antoine-voiry/saucedeck/docs/kb/README.md

# Knowledge cache

Verified facts so nobody re-researches. One topic per file. Format per entry:

- **Fact.** `[verified: <source>, YYYY-MM-DD]` or `[unverified]`

Files:
- [esp32s3.md](esp32s3.md) — ESP32-S3 SoC + SuperMini board
- [toolchain.md](toolchain.md) — pioarduino, PlatformIO, Arduino-ESP32 USB/HID
- [peripherals.md](peripherals.md) — MCP23017 (current), PCF8575 (legacy), EC11, ST7789, WS2812B
