antoine-voiry/saucedeck/docs/superpowers/specs/assets/2026-10-31-candy-mockup.png

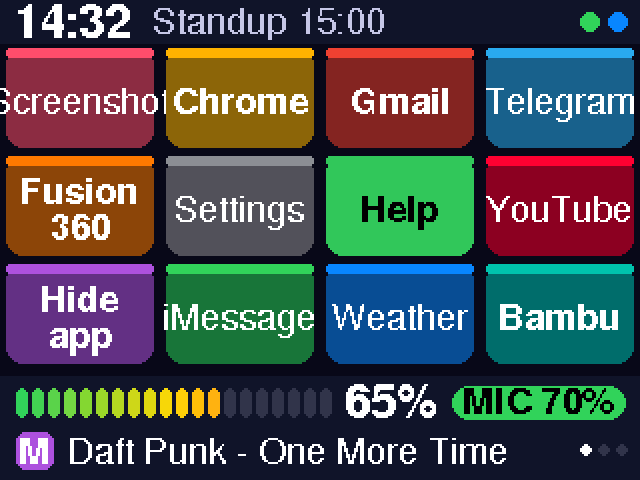
docs/superpowers/specs/assets/2026-10-31-candy-mockup.png
