antoine-voiry/saucedeck/docs/superpowers/specs/assets/2026-10-31-candy-sim.png

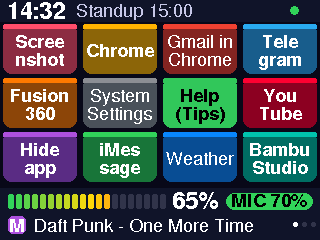
docs/superpowers/specs/assets/2026-10-31-candy-sim.png
