antoine-voiry/saucedeck/hardware/stl/SauceDeck-V1.1-base-pockets.step

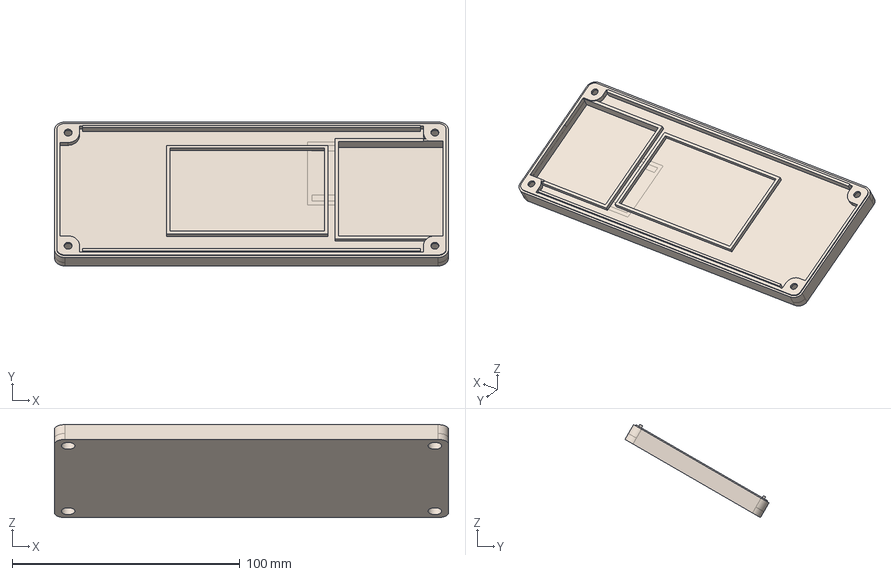
[picture p4: CAD file, 2026-11-08]
hardware/stl/SauceDeck-V1.1-base-pockets.step
173.1 x 63.3 x 41.0 mm
