antoine-voiry/saucedeck/hardware/stl/SauceDeck-V1.1-lcd-bezel.stl

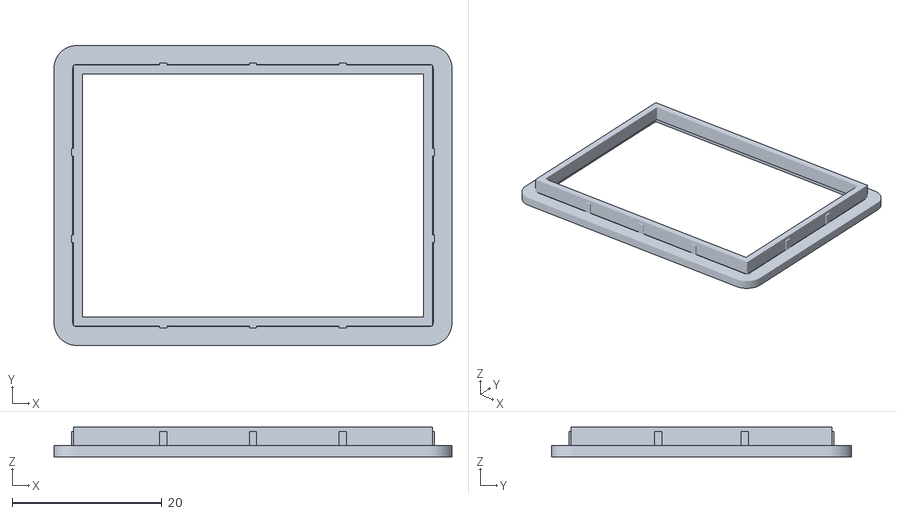
[picture p5: CAD file, 2026-11-08]
hardware/stl/SauceDeck-V1.1-lcd-bezel.stl
53.1 x 40.0 x 4.00
