antoine-voiry/saucedeck/hardware/stl/SauceDeck-V1.1-key-bezel.stl

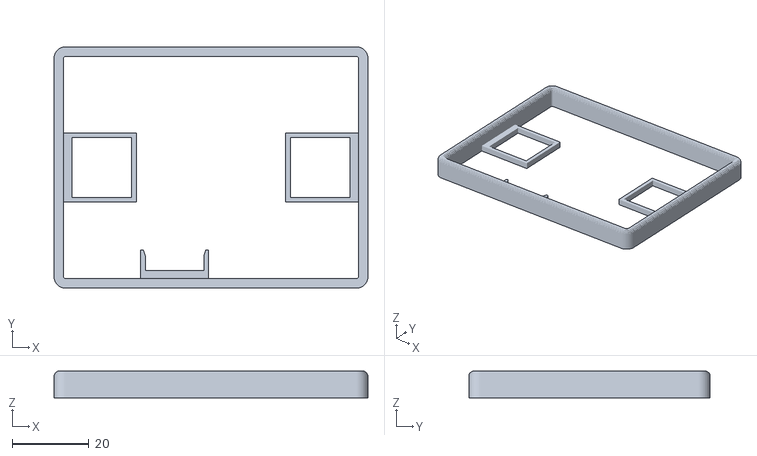
[picture p6: CAD file, 2026-11-08]
hardware/stl/SauceDeck-V1.1-key-bezel.stl
82.0 x 63.0 x 7.00
