antoine-voiry/saucedeck/(list of files, cad)

Other CAD files:
hardware/stl/SauceDeck-V1.1-base-pockets.stl
