antoine-voiry/saucedeck/docs/bringup/README.md

# Bring-up logs

One file per bench session: `YYYY-MM-DD.log`, serial output of the bringup firmware (`pio device monitor`, or `tools/bench.py` replies for host-driven sessions — trimmed to the relevant lines).
Note any rework done between runs at the top of the file.
