antoine-voiry/saucedeck/(commit log)

2026-10-04 Initial SAUCEDECK firmware scaffold
    ESP32-S3-Zero USB HID macro deck on pioarduino (Arduino core 3.x).
    - Enumerates as SAUCEDECK via TinyUSB: keyboard (F13-F24) + consumer control
    - PCF8575 buttons and EC11 encoders through host-tested lib/deck_core
    - Unity native test env, CLAUDE.md (TDD workflow), docs/kb knowledge cache
2026-10-04 Record LED strip cap (470 nF) and DIN resistor (470 Ω) values
2026-10-04 Correct LED strip bulk cap: 70 µF electrolytic, not 470 nF
2026-10-04 Add guided wiring bring-up firmware
    New `bringup` env walks the operator through every signal over USB serial:
    PCF8575 ACK/bus scan, stuck-pin and INT idle checks, ST7789 color fill,
    first WS2812 LED, then each key, knob switch and encoder direction.
    Judging logic (BringupSequencer, describeResult) lives in deck_core with
    21 new native tests; failures name the likely wiring cause.
    Native tests moved to test/native/<suite>; ESP32 config shared via [esp32s3].
    Not bench-verified yet.
    [main.cpp, test_main.cpp]
2026-10-04 Bench session 1: host-driven bring-up, LED + encoders pass
    - bringup firmware: single-key command mode (snapshot, monitor, LCD, LED,
    I2C scan/speed, PCF drive patterns) for Claude-led bench sessions
    - tools/bench.py: send one command, print reply up to OK>
    - platformio.ini: 1200bps touch upload, no BOOT button needed
    - docs/bringup/2026-10-04.log: LED PASS, encoders PASS, LCD dark (BL
    floating), PCF8575 inputs unstable with VCC confirmed at 3.3V (open)
    [bench.py, main.cpp]
2026-10-04 Bench: PCF8575C root cause (open-drain, no pull-ups), module power notes
2026-10-04 Bench: LCD working, pin map corrected to physical wiring
    - pins.h/wiring.md: LCD CS=9 DC=10 SCK=11 MOSI=12 (bench-verified),
    BL tied to 3V3, PCF VDD jumpered to 3V3
    - bringup: tunable ST7789 driver + variant commands (v/V/q/1-3) used to
    find swapped SPI wires by color
    - kb + log: GMT020 BL behaviour, working init sequence, PCF8575C still
    needs external pull-ups
    [main.cpp, pins.h]
2026-10-04 Bench log: button test impossible without PCF pull-ups
2026-10-05 Column-scan buttons on PCF8575C, board is ESP32-S3 SuperMini
    PCF8575C has no pull-ups, so buttons can't be read as plain inputs.
    Scan instead: drive one PCF pin LOW at a time, all button commons on
    GPIO44 (U0RXD) with INPUT_PULLUP. ColumnScanner in deck_core (10 new
    tests); production firmware and bringup ('c' command) use it.
    Also: uploads locked to /dev/cu.usbmodem* after a CH9102 ESP32 got
    auto-picked; docs corrected from S3-Zero to S3 SuperMini.
    Not bench-verified yet (needs commons moved from GND to GPIO44).
    [main.cpp, pins.h, test_main.cpp]
2026-10-18 Move keys to MCP23017 expander, rebuilt wiring bench-verified
    PCF8575C replaced by a Waveshare MCP23017 @ 0x27: internal pull-ups,
    keys to GND, polled. Column scanner removed. New deck_core mcp23017
    module maps raw GPIOA/B to deck bits (physical key order, knob switches
    on GPB4/GPB5) with its own test suite (test_mcp).
    Pin map rebuilt on perfboard (wiring.md, pins.h): LCD SCK=12/MOSI=11
    (IO_MUX native), DC=13, RST=44, BL=9; LED on GPIO6; knob 1 = GPIO3/4,
    knob 2 = GPIO1/2. Bring-up firmware ported, plus I2C idle-gap and
    bit-banged diagnostics for the contact fault seen on the bench.
    Bench-verified 2026-10-18: LCD, LED, 12 keys, 2 knob switches,
    2 encoders (docs/bringup/2026-10-18.log). src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
    [main.cpp, mcp_io.h, pins.h, test_main.cpp]
2026-10-18 Debounce deck keys and knob switches (25 ms)
    MaskDebouncer in deck_core: per-bit settle timer on the active-high
    deck mask, time injected, wrap-safe. A one-sample garbage read (all
    bits pressed) emits nothing. 8 new tests in test_core. src/main.cpp
    feeds the MCP read through it before diffing.
    Ported capability from upstream SauceDeck (C1). Not bench-verified.
2026-10-18 Fix USB name: enumerate as SAUCEDECK
    With CDC_ON_BOOT=1 the Arduino core starts USB before setup(), so the
    USB.productName()/manufacturerName() calls were silently ignored and
    the Mac saw "Espressif ESP32-S3-DevKitC-1-N8". Strings now come from
    USB_PRODUCT / USB_MANUFACTURER build flags.
    Bench-verified 2026-10-18: ioreg shows Product/Manufacturer SAUCEDECK
    on all HID interfaces after flashing.
    [main.cpp]
2026-10-18 Track speaker volume and mute state (open loop)
    VolumeState in deck_core mirrors the host volume in host steps (one
    VOL+/VOL- report = one step, macOS 16 per range, unverified) so the
    display can't drift by rounding. Clamp, mute toggle, VOL+ unmutes,
    sync() reset. New test_volume suite (11 tests). Knob 1 feeds it.
    Ported capability from upstream SauceDeck (C3, C4). No visible effect
    until the LCD screen lands.
    [main.cpp, test_main.cpp]
2026-10-18 Both knob switches = sync; single knob fires on release
    KnobChord in deck_core: both switches held fires SYNC once, then
    nothing until both are released. A single knob fires on release, so
    the start of a two-knob press can't also mute (upstream fired on press).
    8 new tests in test_volume. Sync resets VolumeState to 0 % unmuted.
    Ported capability from upstream SauceDeck (C6). Behaviour change: knob
    mute / play-pause now trigger on release. Not bench-verified.
    [main.cpp, test_main.cpp]
2026-10-18 Deck action map; knob 2 push = mic mute; fix stuck key on bus loss
    Deck in deck_core owns debounce, knob chord, speaker and mic state and
    emits HID-agnostic actions; src/main.cpp only maps them to reports
    (F13-F24, consumer codes, mic-mute chord). New test_deck suite (14).
    - Knob 2 push now sends the mic-mute chord (Cmd+Shift+M, Teams on
    macOS, unverified) and tracks mic mute; was play/pause.
    - Sync (both knobs) also clears mic mute.
    - Bug fix: expander dropping while an F-key was held left it pressed on
    the host. Bus loss now sends ReleaseAll once and resets knob state
    without firing; held keys press again when the bus returns.
    Ported capability from upstream SauceDeck (C5). Not ben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
    [main.cpp, test_main.cpp]
2026-10-18 Volume screen model: bar fill, partial redraw strip, dirty flags
    ui_layout.h in deck_core: percent -> bar fill pixels (rounded), the
    strip between old and new fill to repaint, and a ScreenModel that
    names what changed (bar, bar colour on mute, % text, speaker icon,
    mic). Lets the LCD glue avoid upstream's full-screen clear, which
    flickers and stalls encoder polling. New test_ui suite (13 tests).
    Not wired yet (LCD glue is the next phase).
    [test_main.cpp]
2026-10-18 LCD volume screen: speaker bar + %, speaker and mic icons, splash
    src/display.cpp drives the ST7789 via Adafruit ST7789/GFX (pinned:
    GFX 1.12.6, BusIO 1.17.4, ST7789 1.11.0, seesaw 1.7.9). Redraws only
    what ScreenModel marks dirty, bar by strip, at most every 30 ms. Own
    icons from GFX primitives (upstream bitmaps have no licence). Splash
    for 1.5 s without blocking keys or USB.
    Backlight: GPIO9 HIGH with reduced drive strength. BL current still
    unmeasured; owner accepted the risk.
    Ported capability from upstream SauceDeck (C7, C8). Flashed, not
    bench-verified (orientation, colours, SPI 20 MHz to check).
2026-10-18 LCD rotation 3 (was upside down); Deck emits local Sync action
    Bench 2026-10-18: rotation 1 showed the screen upside down in the
    case, 3 is upright. Sync (both knobs) now emits a local Sync action
    (no HID report) so feedback such as LEDs can react; test updated.
2026-10-18 LED strip feedback per action + volume gauge, power-limited
    LedEffects in deck_core: each action flashes a colour that fades in
    250 ms (per-key hue, mute amber, mic mute red, track skip white, sync
    green, bus loss orange); knob 1 turns show a cyan level gauge for
    1.5 s (grey when muted); idle is dim, dim red while the mic is muted.
    Every frame is scaled to <= 250 mA estimated (60 mA/LED full white)
    to stay inside the 500 mA USB budget. New test_led suite (16 tests).
    src/leds.cpp drives the strip on GPIO6 via Adafruit NeoPixel 1.15.5
    (pinned), 50 fps. kLedCount = 16 is a placeholder: board has >12 LEDs,
    exact count unknown.
    Not in upstream; owner request. Flashed, not bench-verified.
    Co-Au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
    [leds.cpp, leds.h, main.cpp, test_main.cpp]
2026-10-19 Decode knobs in hardware (ESP32-S3 PCNT)
    Polled decoding loses EC11 edges while the loop is busy drawing:
    redraws are estimated at 2-7 ms, edges arrive every 2.5-5 ms when the
    knob is spun fast. The two knobs now use PCNT units in x4 quadrature
    mode with a 1 us glitch filter and accumulated count; DetentCounter in
    deck_core (6 tests) turns counts into detents. Direction is derived
    from the bench-verified QuadDecoder table. Polled QuadDecoder remains
    as fallback if PCNT setup fails.
    Flashed, not bench-verified (direction, detent alignment).
    [encoders.cpp, encoders.h, main.cpp, test_main.cpp]
2026-10-19 LED idle much dimmer (bench: too bright)
    Idle {0,4,12} -> {0,1,3}, mic-muted idle {16,0,0} -> {4,0,0}. Tests
    now cap idle channels at 4. Bench feedback 2026-10-19.
2026-10-19 Bench log 2026-10-19: key 10 open circuit, LCD/LED fixes
2026-10-19 Key map follows the 2026-10-19 rewire
    Bench (bringup, keys pressed 1..12 in order): positions 5-7 now on
    GPA3/GPA2/GPA1 and 9-11 on GPA4/GPA5/GPA6, i.e. the two rows swapped
    during the rewire. Positions 1-4, 8 and the knob switches unchanged.
    Position 12 = GPA0 assumed (only free input; key 12 still open).
    mcp23017.cpp map, test_mcp expectations and wiring.md updated
    together. The bring-up describe test now asks deckPinName() instead
    of hard-coding a pin.
    [test_main.cpp]
2026-10-19 LED board has 16 LEDs (owner count)
2026-10-20 Key map follows the 2026-10-20 rewire of the 7 bottom keys
    Bench (bringup, cmd M, keys pressed 1..12 in order): positions 5-7 on
    GPA2/GPA1/GPA0 and 9-12 on GPA3/GPA6/GPA5/GPA4. Positions 1-4, 8 and
    the knob switches unchanged. Key 12 now reads (was open). All 12 keys
    land on distinct input pins.
    mcp23017.cpp map, test_mcp expectations and wiring.md updated together.
    native 115/115, saucedeck + bringup build OK. Bench-verified (raw pins);
    HID key codes on the Mac not bench-verified.
2026-10-21 Fix double key press on I2C glitch; volume display drift on fast spin
    Review findings, both reproduced in failing tests first:
    - One failed expander read was treated as bus loss: held F-keys got
    ReleaseAll and were pressed again 25 ms later, so a single glitch on
    the flaky GPA header looked like a double press on the host. Bus loss
    now needs 20 ms of continuous read failures (Deck::onReadFailed);
    a good read restarts the timer. Stuck-key protection unchanged.
    - onEncoders counted every detent into VolumeState but ActionList drops
    reports beyond 32, so a very fast spin let the screen drift from the
    host. Steps are now clamped to the room left in the list.
    4 new tests, 119/119 pa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
    [main.cpp, test_main.cpp]
2026-10-21 Plan: firmware for configurable keys, Wi-Fi portal, helper link
    18 TDD tasks from the approved 2026-10-20 spec: two bench spikes first
    (WiFiManager on core 3.x, vendor HID to macOS), then deck_core logic
    (keystroke, KeyMap + NVS blob, KnobChord v2, HelperProto, HostLink,
    WifiSession, Deck routing, staged map confirm, LED Wi-Fi mode, screen
    banners), then glue, CI radio scope and a bench session. Three spec
    deltas flagged for owner OK. Mac helper = separate plan.
2026-10-21 Spike A: WiFiManager 2.0.17 builds on core 3.x (bench pending)
    spike_wifi env + firmware: AP portal with two custom params, STA web
    portal after join. Build: SUCCESS, 0 warnings, 83.4 % of the default
    app partition. Production env excludes spike dirs.
    Bench (portal fields, save callback, STA /param page) not done yet:
    two serial captures (5 + 15 min) saw no operator interaction.
    Production firmware restored on the board.
2026-10-21 Deck: staged key map, knob 1 confirms within 30 s, else discarded
    On commit: ReleaseAll first, then keys still held are pressed again on
    the next scan under the new map.
2026-10-21 LED Wi-Fi mode (30 mA, blue pulse) + screen banner and mic level model
2026-10-21 Idle dimming: fade LEDs + LCD backlight after 120 s, off at 240 s
    LCD backlight now PWM (LEDC, 5 kHz, squared curve) on GPIO9, panel
    sleeps at 0. Any input wakes and still acts; a pending key-map change
    or the two-knob countdown keeps it awake. Owner request 2026-10-21.
    Flashed, not bench-verified.
2026-10-21 Execute keystroke entries via pressRaw; key map persisted in NVS
    Defaults (F13-F24) unchanged in behaviour; corrupt stored map falls back
    to defaults with a notice flag; brownout reset reason captured for the
    banner. Flashed, not bench-verified.
    [keymap_store.cpp, main.cpp]
2026-10-21 Spike B: vendor HID shares the keyboard interface -> macOS needs Input Monitoring
    USBHIDVendor (usage page 0xFF00, report ID 6, 63 B) lives in the same
    HID interface as the keyboard and consumer collections. macOS shows one
    IOHIDDevice (primary usage keyboard); the probe had to match on
    DeviceUsagePage. Unprivileged open: kIOReturnNotPermitted, so the Mac
    helper would need Input Monitoring. Plan stop condition hit; transport
    decision pending with owner. Production firmware restored.
2026-10-22 Spec + plan: helper transport = framed USB serial (spike B outcome)
2026-10-22 Helper link over USB serial: framed HelperProto, FrameReader resync
    Spike B outcome: vendor HID would need macOS Input Monitoring, so the
    helper talks over the existing CDC port. Frames A5 5A | 63-byte message
    | CRC16-CCITT; FrameReader skips junk and rescans after bad CRCs (7 new
    tests incl. 200k random bytes -> 0 frames). Glue: helper_link.cpp
    (bounded reads, 20 ms TX timeout, USB stop resets presence). Display
    shows the Mac's real volume/mic when the helper is present.
    tools/helper_sim.py plays the helper for bench tests. Bench: 8 s of
    HELLO/VOLUME/MIC + random junk, deck stayed up (no reset). Display and
    deck->host messages not yet operator-verified.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
    [helper_link.cpp, helper_link.h, helper_sim.py, main.cpp, test_main.cpp]
2026-10-22 Wi-Fi settings portal (WiFiManager) behind 5 s two-knob hold, LCD prompts
    wifi_portal.cpp (only Wi-Fi file): joins home Wi-Fi or opens the
    SAUCEDECK-setup hotspot with a random 8-digit password per session,
    12 key fields (type + value) on the WiFiManager page, saves are staged
    and need a knob 1 press. 11 dBm TX power, LEDs in 30 mA Wi-Fi mode,
    10 min auto-off. Banner line: countdown, setup password, Apply?,
    invalid key, helper missing, Wi-Fi failed, key map reset, brownout.
    Mic area shows the helper's real mic % when known.
    Chip verified with esptool: ESP32-S3FH4R2 (4 MB flash, 2 MB PSRAM), so
    the app partition moves to huge_app.csv (firmware is 1.21 MB).
    Flashed; Wi-Fi bench (phone) not do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
    [display.cpp, display.h, leds.cpp, leds.h, main.cpp, wifi_portal.cpp, wifi_portal.h]
2026-10-22 CI radio scope: no BT, Wi-Fi only from wifi_portal.cpp; security docs
    check_radio_scope.sh replaces check_no_radio.sh. Verified: passes on
    the current build, fails (exit 1) when Wi-Fi is put into leds.cpp.
    SECURITY.md baseline updated for the Wi-Fi portal and serial helper link.
2026-10-22 Fix cppcheck findings: FrameReader buffer init, %u args in portal labels
    [wifi_portal.cpp]
2026-10-22 LED: key N lights N LEDs in a rainbow, also while Wi-Fi is on
    Owner request 2026-10-22 (bench: no key feedback in Wi-Fi mode). Key /
    helper-action flashes light the first N LEDs, hue shifted per key; in
    Wi-Fi mode they show on top of the blue pulse, still capped at 30 mA.
    hsvToRgb helper. Flashed, not bench-verified.
2026-10-22 Bench log: LED key pattern pass; Wi-Fi stale-joined finding
2026-10-22 Bench: deck reachable from operator device; Mac blocked at L2 (AP isolation suspected)
2026-10-24 Portal preset loader + Mac daily preset (F13-F24 via macOS Shortcuts)
    - /param page: "Load preset" file picker fills the 24 key fields from a
    JSON preset in the browser. Deck still validates on Save and waits for
    the knob 1 confirm.
    - presets/mac-daily.json: F13..F24 in order (same as factory default).
    macOS Shortcuts app maps each F-key to an action, nothing to install on
    the Mac. Setup table in docs/mac-shortcuts.md.
    - Keystroke parser: "/" key (HID 0x38).
    Not bench-verified: preset loader in a real browser, Shortcuts F-key capture.
    [test_main.cpp, wifi_portal.cpp]
2026-10-24 Mac actions via Hammerspoon; preset avoids F21-F24
    macOS drops F21-F24 (no virtual keycode) and the Shortcuts app recorded no
    hotkey at all on 26.7.1, so the Shortcuts route is replaced by Hammerspoon.
    - presets/mac-daily.json: keys 1-8 F13-F20, key 9 cmd+h, keys 10-12
    ctrl+alt+cmd+F13..F15.
    - tools/mac/hammerspoon.lua: binds those keys to apps / Chrome URLs.
    - docs/mac-setup.md replaces docs/mac-shortcuts.md; host key facts in kb.
    Bench-verified: keys 4 (Telegram) and 8 (YouTube) via Hammerspoon.
    Not bench-verified: keys 1-3, 5-7, 9-12 (need the preset loaded on the deck).
    [test_main.cpp]
2026-10-24 Bench log 2026-10-24: HID keys on Mac, LCD + LED strip OK together
2026-10-24 Bench: LCD backlight on GPIO9 = 19 mA, within 20 mA limit
2026-10-24 Spec: device simulation + 95% line/branch coverage gate
2026-10-24 Plan 1/4: device sim coverage tooling, sim core, key scenarios
2026-10-24 Device sim: fakes + SimBoard + fork-per-test harness; firmware boots on host
    Real src/ (minus bringup/spikes) compiles unchanged against test/sim/lib/simdeck.
    3 tests: harness isolation (fails without fork), boot MCP init, idle sends nothing.
    Harness checked by breaking it: no fork, failing assert (message points at the
    child's line), crash (signal 11).
    [test_main.cpp]
2026-10-24 Sim: 12 keys end to end with the default map, debounce, two-key hold
    Mutation check: swapping two kRawBit entries fails 'key 1'.
    [test_main.cpp]
2026-10-24 Sim: mac-daily preset from NVS, chord modifier order as the Mac sees it
    Loads the real presets/mac-daily.json. Mutation check: key sent before its
    modifiers in src/main.cpp fails the modifier-order test.
    [test_main.cpp]
2026-10-24 Sim: expander loss, glitch, hot-plug and absent-at-boot scenarios
    Mutation check: onBusLost pushing Sync instead of ReleaseAll fails the
    bus-loss test (plan step corrected: commenting the line out breaks -Werror).
    [test_main.cpp]
2026-10-24 CI runs device sim tests; CLAUDE.md: sim + coverage commands
    Coverage now (deck_core + src/, macOS clang): lines 76.4%, branches 69.6%.
    src/bringup not compiled with coverage yet (plan 4 must check every src file
    appears in the report).
2026-10-31 LCD: 4x3 key legends + status strip, tile press feedback
    Replaces the volume screen (vertical bar, speaker/mic icons) with the split layout from
    the 2026-10-31 spec. Not bench-verified: legibility and fade feel need the panel.
    [display.cpp, display.h, main.cpp, test_main.cpp]
2026-10-31 test_proto: fuzz reaches the TIME/CARD accept path; short-buffer card test
    Fuzz generator now builds mostly well-formed CARD/TIME frames (slot/icon
    in range, len consistent with tlen, printable text on 3 of 4 iterations,
    tz across -1000..+1000) with 1-in-8 out-of-range perturbations. Asserts
    both accept and reject counts are non-zero for each type.
    Adds test_decode_card_rejects_short_buffer: valid 48-char card rejected
    for n < 8 and n < 3+len, accepted at exact frame length.
    [test_main.cpp]
2026-10-31 LCD: clock and slot 0 in the top bar, rotating status cards on the strip
    Not bench-verified: needs the helper (tools/helper_sim.py --clock --card=...).
2026-10-31 Status repaint scope: split StatusBoard gen into topGen/stripGen
    Rotation or non-current card refresh no longer blanks the top bar, and
    strip changes do not repaint line 2 while a banner is shown.
    [main.cpp, test_main.cpp]
2026-10-31 Plan 3: Hammerspoon helper (host-tested Lua core + glue + pre-upload release)
2026-10-31 Mac helper: Lua frame/protocol module with host tests matching helper_sim
2026-10-31 Mac helper: Hammerspoon glue, pre-upload port release, setup docs
    Not bench-verified: needs the helper loaded in Hammerspoon and a deck on USB.
2026-10-31 Mac helper: connect only to SAUCEDECK product, long release, port-loss handling
    Helper connects only when USB product is exactly SAUCEDECK; env:bringup now
    enumerates as SAUCEDECK-BRINGUP so the helper leaves it alone. release(seconds)
    and resume() added; bench.py releases the port automatically. Port closed/error/
    vanished now disconnects; music queried only when player app runs; failed open
    closes the port. Not bench-verified.
    [bench.py, release_helper.py]
2026-10-31 Sim: RGB565 framebuffer, real GFX fonts, BMP screenshots
2026-10-31 LCD: Candy theme (per-key colours, rounded tiles, gradient volume, mic pill, card dots)
    src/display.cpp redrawn with theme.h: per-key hue tiles (74x50, r8, hue
    band), chooseLegend labels (bold/regular, 1-2 lines), 20 gradient volume
    segments repainted by segDelta, % text box cleared before the custom font,
    mic pill, card icon + dots (card text stops 4 px before the first dot),
    Candy splash. ScreenModel dirty flags and repaint scopes unchanged.
    Deviations: muted speaker shows "OFF" and muted mic "MIC OFF"; "MUTED"
    (87 px bold 12) and "MIC MUTE" (93 px bold 9) do not fit the 51 px box /
    87 px pill. "100%" falls back to FreeSansBold9pt (61 px > 51 px box).
    Sim: SimLcd records fillRoundRect an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
    [display.cpp, test_main.cpp]
2026-11-01 Reset log: reason + previous uptime, banner and portal history
    The deck reset by itself once (2026-11-01, ~16:19) and left no trace: only
    brownout was ever detected. Now every boot records esp_reset_reason() and the
    crashed run's uptime (kept in RTC_NOINIT memory, refreshed once a second) in
    NVS "saucedeck"/"resets" (last 8). Any non-power-on reset shows
    "Reset: <reason>, up <time>" on line 2 for 30 s (was brownout only, 8 s), and
    the portal param page lists the history.
    Pure logic in deck_core reset_log.h (test_reset, 8 tests); sim scenarios for
    banner, power-on and append. rtcMagic/rtcUpS checked in .rtc_noinit
    (0x50000200) in firmware.elf. RTC survival across panic/WDT not bench-verified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
    [display.cpp, display.h, main.cpp, reset_store.cpp, reset_store.h, test_main.cpp, wifi_portal.cpp, wifi_portal.h]
2026-11-08 Icons: 20 built-in 24x24 key icons (ASCII art, lookup, runs)
    lib/deck_core/src/icons.h: art as ASCII row tables, names table,
    iconArt / iconName / iconByName / iconRuns. Pure C++17, no heap.
    test_icons suite: shape, border, names, lookup, runs rebuild every row,
    bounds and cap. tools/icons_preview.py renders a contact sheet (Pillow).
    Not wired into src/ yet (later tasks). Not bench-verified.
2026-11-08 Key map: per-key icon (blob v3, portal field, preset icons)
    KeyEntry.icon, KeyMap::setIcon/setIconId, blob v3 (v1/v2 still load, icon id > 20 rejected),
    portal icon field i<n> with names line and preset JS support, mac-daily preset icons and
    short labels, sim preset loader reads optional icon bounded to its own key.
    Portal Save not covered by a sim test (no existing portal sim). Not bench-verified.
    [test_main.cpp, wifi_portal.cpp]
2026-11-08 LCD: icon tiles (24x24 icon above one-line label)
    Keys with an icon draw its runs with drawFastHLine in a 24x24 box at
    (x+25, y+8) in the tile text colour (white idle, black from half fade),
    and one label line at baseline y+45 via chooseOneLine (bold, regular,
    else regular cut with "..."). Icon 0 keeps the Plan 4 text tile.
    Sim records/rasterizes drawFastHLine (hlines). Screenshot of the
    mac-daily preset: docs/superpowers/specs/assets/2026-11-08-icons-sim.png.
    Docs: mac-setup labels + icons, legends spec note, kb flash size.
    Not bench-verified.
2026-11-08 Spec/plan 5: icon labels in generated FreeSans 7pt, 72 px, baseline y+44
    9pt cut 6 of 12 preset labels (Screenshot 91 px regular vs 68 px).
2026-11-08 LCD: icon labels in FreeSans 7pt (all preset labels fit)
    Icon tile label: generated FreeSansBold7pt7b if it fits 72 px, else
    FreeSans7pt7b, else regular cut with "...", baseline y+44. Fonts from
    GNU FreeFont 20120503 via Adafruit GFX 1.12.6 fontconvert (DPI 141),
    committed in include/fonts/, rebuilt by tools/make_label_fonts.sh
    (sha256-checked download, temp work dir). All 12 mac-daily labels now
    print whole (sim test). Screenshot PNG regenerated.
    Known: bold 7pt 'i'/'j' render dotless (fontconvert output), see kb.
    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
2026-11-08 LCD: icon labels regular 7pt only
    Bold 7pt (fontconvert output) draws i/j without a dot ("Gmall"), so
    icon tile labels are FreeSans 7pt regular only, fitLine "..." cut past
    72 px, baseline y+44. chooseOneLine removed (it reduced to fitLine with
    one font) with its theme tests; display.cpp calls fitLine directly.
    FreeSansBold7pt7b.h dropped from include/fonts and the font script.
    Sim test checks every mac-daily label is printed whole in the regular
    7pt face. Screenshot PNG regenerated.
    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
2026-11-08 Icons: ODR-safe inline constexpr tables, portal v2->v3 upgrade sim test, doc fixes
    [test_main.cpp]
2026-11-08 Fix: crash when Wi-Fi turns off while joined (double portal shutdown)
    Bench 2026-11-08: deck rebooted whenever Wi-Fi went off on the home network
    (knob toggle or 10 min auto-off). Core dump from the coredump partition:
    LoadProhibited at 0x0 in WiFiManager::shutdownConfigPortal
    (WiFiManager.cpp:970, server->handleClient()) <- portalStop()
    (src/wifi_portal.cpp) <- run() main.cpp:94.
    portalStop() called stopWebPortal() (frees the server) and then
    stopConfigPortal(), whose shutdown dereferences the freed server. Now one
    stopWebPortal() only: it returns early with no portal up and otherwise shuts
    down both the web portal and the config AP.
    Sim WiFiManager now models 2.0.17 server lifetime and a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
    [test_main.cpp, wifi_portal.cpp]
2026-11-08 Go public: README, MIT license, SauceDeck credits, enclosure remix (CC BY-NC-SA 4.0)
    - README with credits to HotTabascoSauce's SauceDeck (GitHub firmware and
    MakerWorld v1.1 enclosure).
    - LICENSE: MIT for firmware, tools and docs; hardware/ excluded.
    - hardware/: remixed v1.1 Base (perfboard/MCP23017/LED pockets, +3 mm plate),
    new key and LCD bezels, under CC BY-NC-SA 4.0 like the original model,
    with attribution and a list of changes.
    - CLAUDE.md and logs/ stay local: untracked and ignored.
    [SauceDeck-V1.1-base-pockets.step, SauceDeck-V1.1-base-pockets.stl, SauceDeck-V1.1-key-bezel.stl, SauceDeck-V1.1-lcd-bezel.stl]
